freakdoctor/GameboyPi/GameboyPi2.png

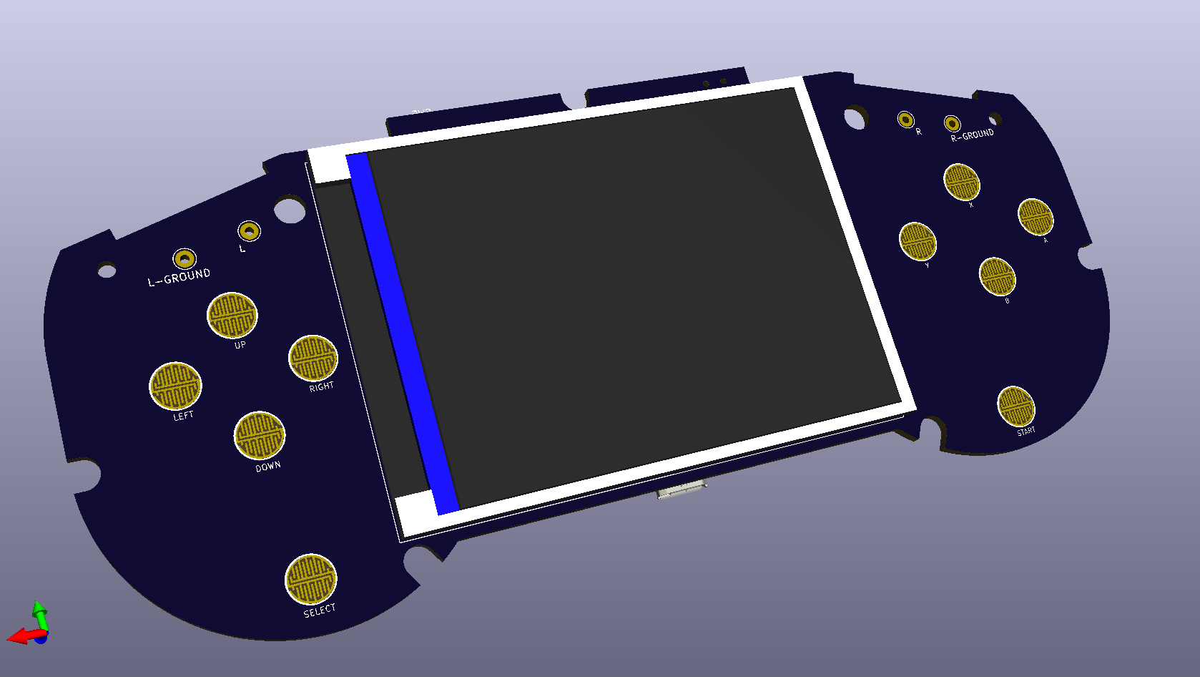
GameboyPi2.png
