freakdoctor/GameboyPi/GameboyPi.png

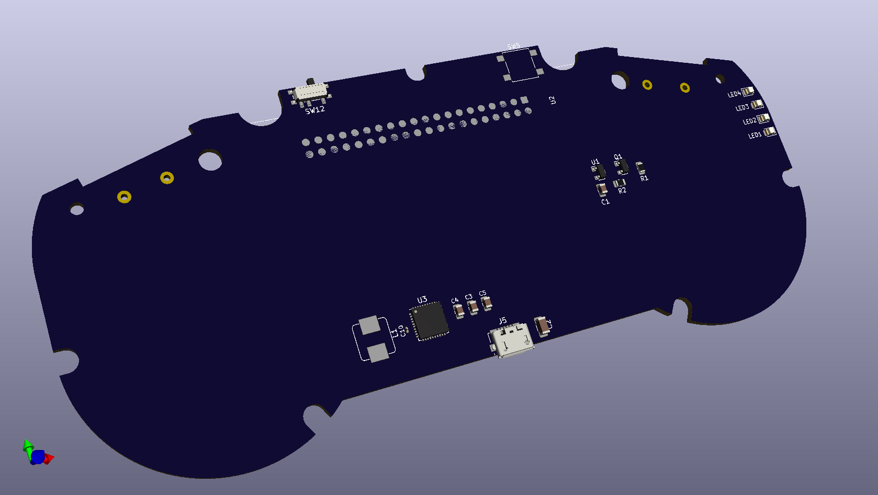
GameboyPi.png
