freakdoctor/GameboyPi/GameboyPi.kicad_pcb

## KiCad design GameboyPi.kicad_pcb (2022-04-14)

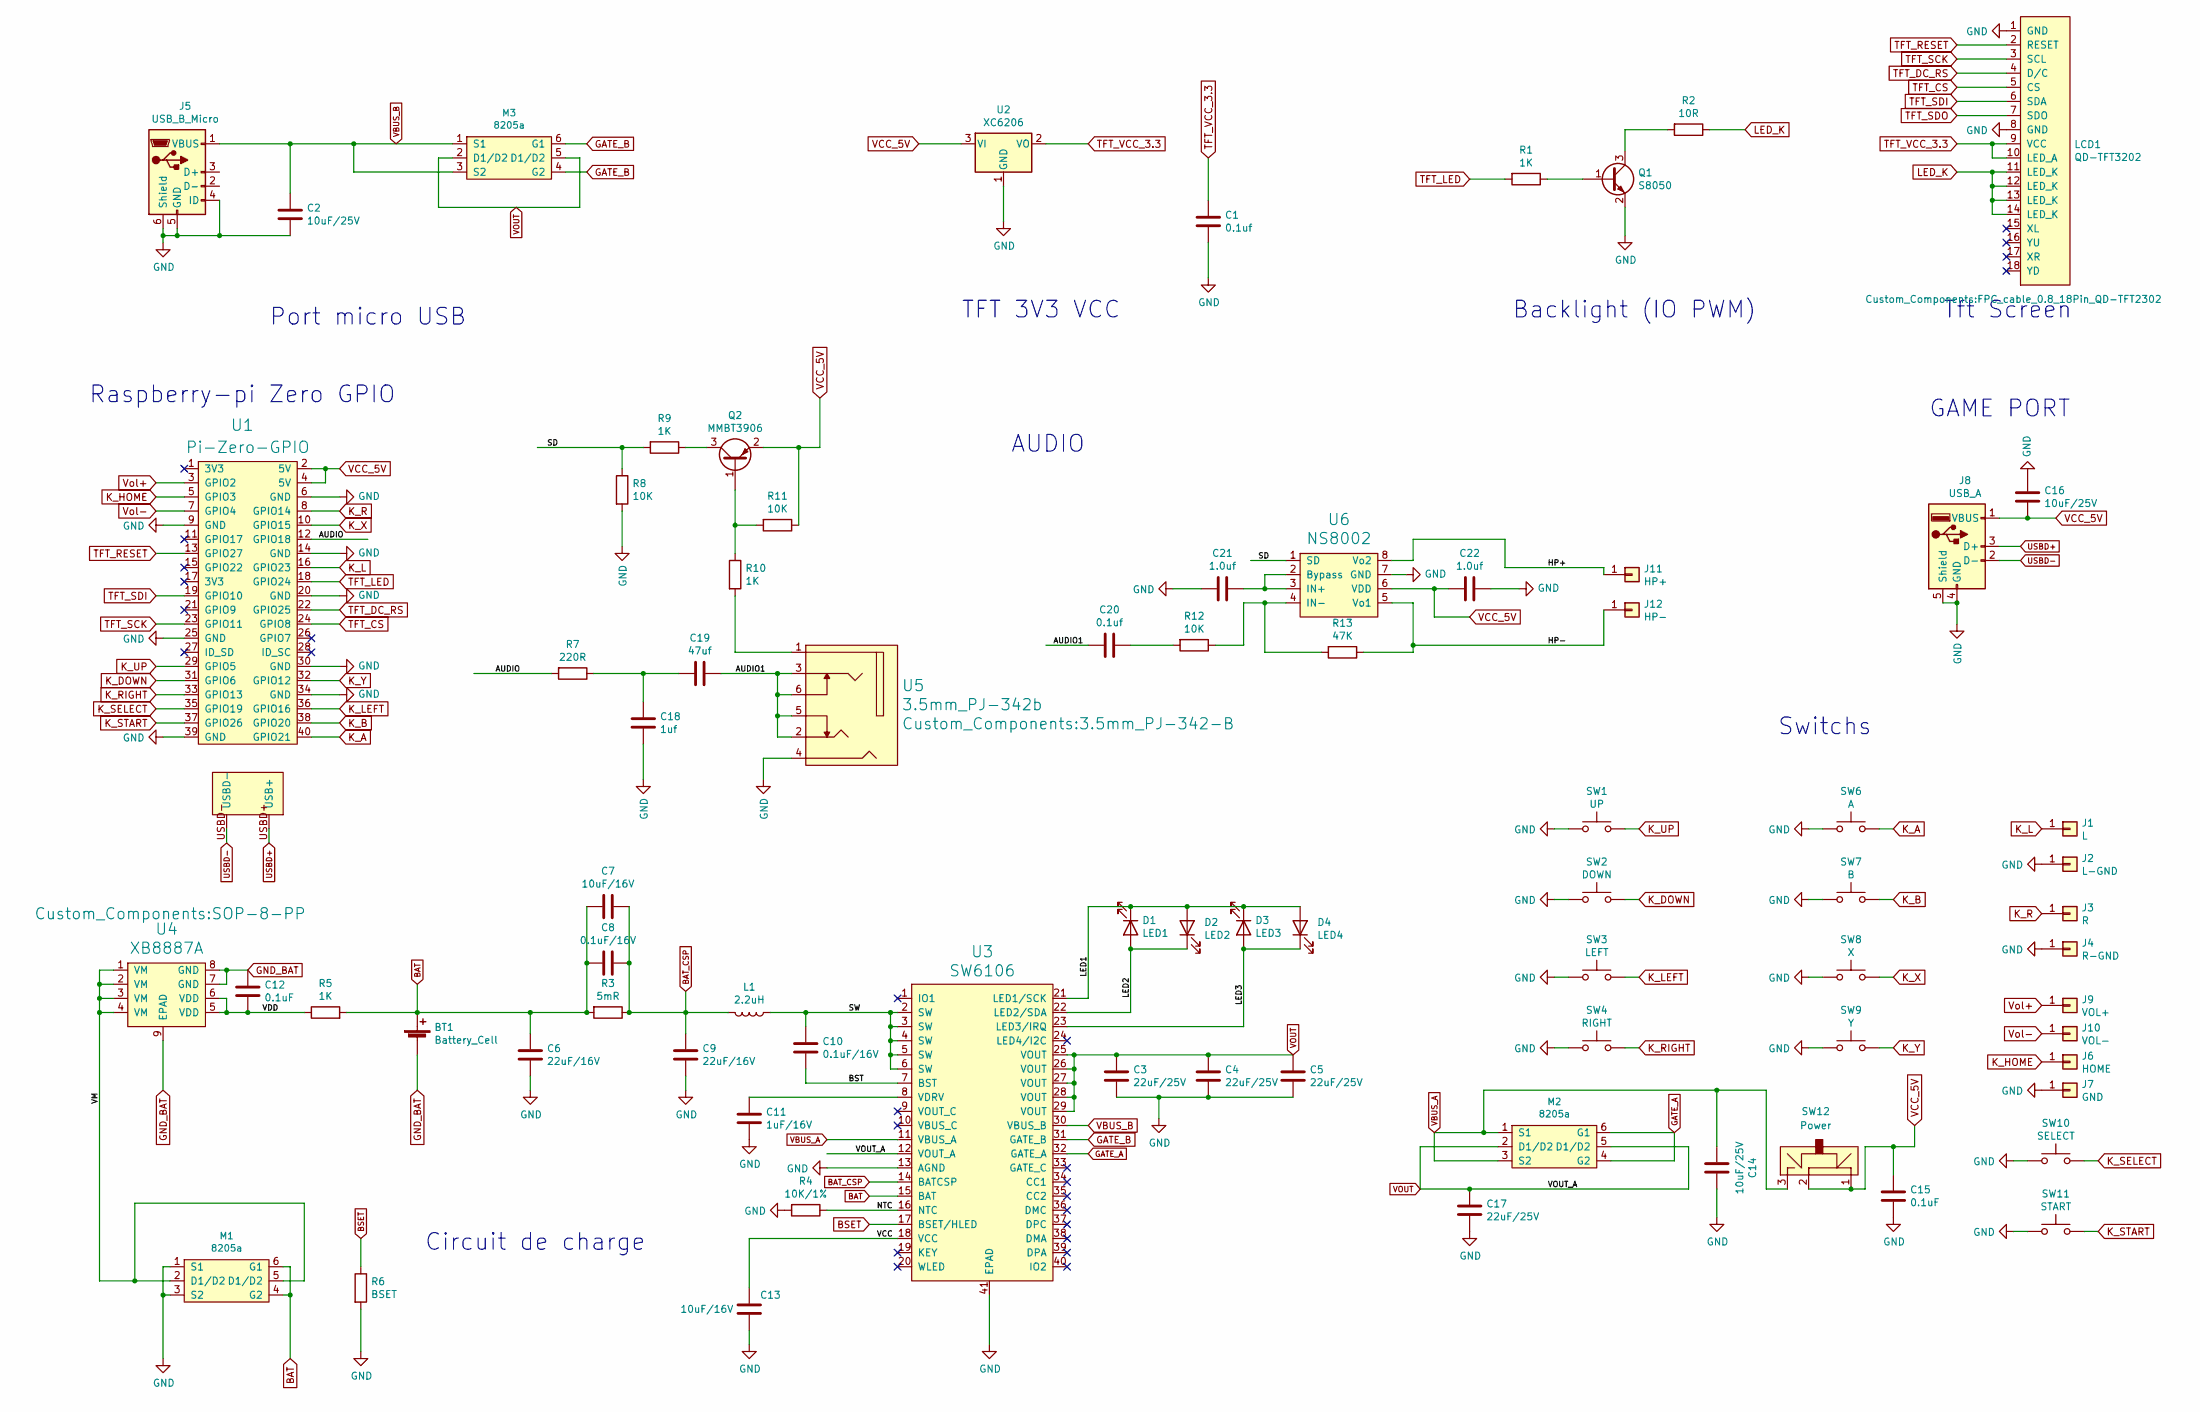
[picture p3: schematic GameboyPi.sch]

Parts:
BT1: Battery_Cell; Li-Po_3.7
C1: 0.1uf; C_0805_2012Metric; LCSC C286511
C2, C16: 10uF/25V; C_1206_3216Metric; LCSC C90538
C3, C4, C5, C17: 22uF/25V; C_0805_2012Metric; LCSC C90153
C6, C9: 22uF/16V; C_0805_2012Metric; LCSC C116973
C7, C13: 10uF/16V; C_0603_1608Metric; LCSC C70225
C8, C10: 0.1uF/16V; C_0603_1608Metric; LCSC C307478
C11: 1uF/16V; C_0603_1608Metric; LCSC C307478
C12: 0.1uF; C_0603_1608Metric; LCSC C307478
C14: 10uF/25V; C_1206_3216Metric; LCSC C70225
C15: 0.1uF; C_1206_3216Metric; LCSC C105213
C18: 1uf; C_0603_1608Metric
C19: 47uf; C_0603_1608Metric
C20: 0.1uf; C_0603_1608Metric
C21, C22: 1.0uf; C_0603_1608Metric
D1: LED1; LED_0805_2012Metric; LCSC C138557
D2: LED2; LED_0805_2012Metric; LCSC C138557
D3: LED3; LED_0805_2012Metric; LCSC C138557
D4: LED4; LED_0805_2012Metric; LCSC C138557
J1: L; Pin_D1.0mm_L10.0mm_LooseFit
J2: L-GND; Pin_D1.0mm_L10.0mm_LooseFit
J3: R; Pin_D1.0mm_L10.0mm_LooseFit
J4: R-GND; Pin_D1.0mm_L10.0mm_LooseFit
J5: USB_B_Micro; USB_Micro-B_Molex_47346-0001; LCSC C132560
J6: HOME; Edge_connection
J7: GND; Edge_connection
J8: USB_A; USB_A_Molex_67643_Horizontal; LCSC C2765194
J9: VOL+; Edge_connection
J10: VOL-; Edge_connection
J11: HP+; Edge_connection
J12: HP-; Edge_connection
L1: 2.2uH; L_Abracon_ASPI-0630LR
LCD1: QD-TFT3202; FPC_cable_0.8_18Pin_QD-TFT2302
M1, M2, M3: 8205a; SOT-23-6; LCSC C2762931
Q1: S8050; SOT-23; LCSC C2146
Q2: MMBT3906; SOT-23
R1: 1K; R_0805_2012Metric; LCSC C269744
R2: 10R; R_0805_2012Metric; LCSC C17477
R3: 5mR; R_1206_3216Metric; LCSC C601096
R4: 10K/1%; R_0603_1608Metric; LCSC C116677
R5: 1K; R_0603_1608Metric; LCSC C269704
R6: BSET; R_0805_2012Metric
R7: 220R; R_0603_1608Metric
R8, R11, R12: 10K; R_0603_1608Metric
R9, R10: 1K; R_0603_1608Metric
R13: 47K; R_0603_1608Metric
SW1: UP; Kbpad
SW2: DOWN; Kbpad
SW3: LEFT; Kbpad
SW4: RIGHT; Kbpad
SW6: A; Kbpad
SW7: B; Kbpad
SW8: X; Kbpad
SW9: Y; Kbpad
SW10: SELECT; Kbpad
SW11: START; Kbpad
SW12: Power; SW_SPDT_PCM12
U1: Pi-Zero-GPIO; Pi_Zero_SMD
U2: XC6206; SOT-23; LCSC C5446
U3: SW6106; QFN-40-1EP_6x6mm_P0.5mm_EP4.6x4.6mm_ThermalVias; LCSC C406803
U4: XB8887A; SOP-8-PP
U5: 3.5mm_PJ-342b; 3.5mm_PJ-342-B
U6: NS8002; SOP-8-PP

Connections:
/AUDIO: R7.2, U1.12 (GPIO18)
/AUDIO1: C19.1, C20.2, U5.2, U5.3, U5.5, U5.6
/BST: C10.1, U3.7 (BST)
/HP+: J11.1, U6.8 (Vo2); also elsewhere on the board
/HP-: J12.1, R13.1, U6.5 (Vo1); also elsewhere on the board
/LED1: D1.1 (K), D2.2 (A), D3.1 (K), D4.2 (A), U3.21 (LED1/SCK)
/LED2: D1.2 (A), D2.1 (K), U3.22 (LED2/SDA)
/LED3: D3.2 (A), D4.1 (K), U3.23 (LED3/IRQ)
/NTC: R4.1, U3.16 (NTC)
/SD: R8.1, R9.2, U6.1 (SD)
/SW: C10.2, L1.1, U3.2 (SW), U3.3 (SW), U3.4 (SW), U3.5 (SW), U3.6 (SW)
/VCC: C13.2, U3.18 (VCC)
/VDD: C12.2, R5.1, U4.5 (VDD), U4.6 (VDD)
/VM: M1.2 (D1/D2), M1.5 (D1/D2), U4.1 (VM), U4.2 (VM), U4.3 (VM), U4.4 (VM)
BAT: BT1.1 (+), C6.1, C7.2, C8.2, M1.4 (G2), M1.6 (G1), R3.2, R5.2, U3.15 (BAT); also elsewhere on the board
BAT_CSP: C7.1, C8.1, C9.1, L1.2, R3.1, U3.14 (BATCSP)
BSET: R6.1, U3.17 (BSET/HLED)
GATE_A: M2.4 (G2), M2.6 (G1), U3.32 (GATE_A)
GATE_B: M3.4 (G2), M3.6 (G1), U3.31 (GATE_B)
GND: C1.2, C2.2, C3.2, C4.2, C5.2, C6.2, C9.2, C11.2, C13.1, C14.1, C15.2, C16.1, C17.2, C18.1, C21.2, C22.1, J2.1, J4.1, J5.4 (ID), J5.5 (GND), J5.6 (Shield), J7.1, J8.4 (GND), J8.5 (Shield), LCD1.1 (GND), LCD1.8 (GND), M1.1 (S1), M1.3 (S2), Q1.2 (E), R4.2, R6.2, R8.2, SW1.1, SW2.1, SW3.1, SW4.1, SW6.1, SW7.1, SW8.1, SW9.1, SW10.1, SW11.1, U1.6 (GND), U1.9 (GND), U1.14 (GND), U1.20 (GND), U1.25 (GND), U1.30 (GND), U1.34 (GND), U1.39 (GND), U2.1 (GND), U3.13 (AGND), U3.41 (EPAD), U5.4, U6.7 (GND)
GND_BAT: BT1.2 (-), C12.1, U4.7 (GND), U4.8 (GND), U4.9 (EPAD); also elsewhere on the board
K_A: SW6.2, U1.40 (GPIO21)
K_B: SW7.2, U1.38 (GPIO20)
K_DOWN: SW2.2, U1.31 (GPIO6)
K_HOME: J6.1, U1.5 (GPIO3)
K_L: J1.1, U1.16 (GPIO23)
K_LEFT: SW3.2, U1.36 (GPIO16)
K_R: J3.1, U1.8 (GPIO14)
K_RIGHT: SW4.2, U1.33 (GPIO13)
K_SELECT: SW10.2, U1.35 (GPIO19)
K_START: SW11.2, U1.37 (GPIO26)
K_UP: SW1.2, U1.29 (GPIO5)
K_X: SW8.2, U1.10 (GPIO15)
K_Y: SW9.2, U1.32 (GPIO12)
LED_K: LCD1.11 (LED_K), LCD1.12 (LED_K), LCD1.13 (LED_K), LCD1.14 (LED_K), R2.1
unnamed: C11.1, U3.8 (VDRV)
unnamed: C18.2, C19.2, R7.1
unnamed: C20.1, R12.2
unnamed: C21.1, U6.2 (Bypass), U6.3 (IN+)
unnamed: Q1.1 (B), R1.1
unnamed: Q1.3 (C), R2.2
unnamed: Q2.1 (B), R10.1, R11.2
unnamed: Q2.3 (C), R9.1
unnamed: R10.2, U5.1
unnamed: R12.1, R13.2, U6.4 (IN-)
TFT_CS: LCD1.5 (CS), U1.24 (GPIO8)
TFT_DC_RS: LCD1.4 (D/C), U1.22 (GPIO25)
TFT_LED: R1.2, U1.18 (GPIO24)
TFT_RESET: LCD1.2 (RESET), U1.13 (GPIO27)
TFT_SCK: LCD1.3 (SCL), U1.23 (GPIO11)
TFT_SDI: LCD1.6 (SDA), U1.19 (GPIO10)
TFT_SDO: LCD1.7 (SDO)
TFT_VCC_3.3: C1.1, LCD1.9 (VCC), LCD1.10 (LED_A), U2.2 (VO)
USBD+: J8.3 (D+), U1.USBD+ (USB+)
USBD-: J8.2 (D-), U1.USBD-
VBUS_A: C14.2, M2.1 (S1), M2.3 (S2), SW12.3, U3.11 (VBUS_A)
VBUS_B: C2.1, J5.1 (VBUS), M3.1 (S1), M3.3 (S2), U3.30 (VBUS_B)
VCC_5V: C15.1, C16.2, C22.2, J8.1 (VBUS), Q2.2 (E), R11.1, SW12.1, SW12.2, U1.2 (5V), U1.4 (5V), U2.3 (VI), U6.6 (VDD)
VOUT: C3.1, C4.1, C5.1, C17.1, M2.2 (D1/D2), M2.5 (D1/D2), M3.2 (D1/D2), M3.5 (D1/D2), U3.12 (VOUT_A), U3.25 (VOUT), U3.26 (VOUT), U3.27 (VOUT), U3.28 (VOUT), U3.29 (VOUT)
Vol+: J9.1, U1.3 (GPIO2); also elsewhere on the board
Vol-: J10.1, U1.7 (GPIO4); also elsewhere on the board

Notes on the sheet:
TFT 3V3 VCC
Raspberry-pi Zero GPIO
Port micro USB
Circuit de charge
GAME PORT
Switchs
Backlight (IO PWM)
Tft Screen
AUDIO

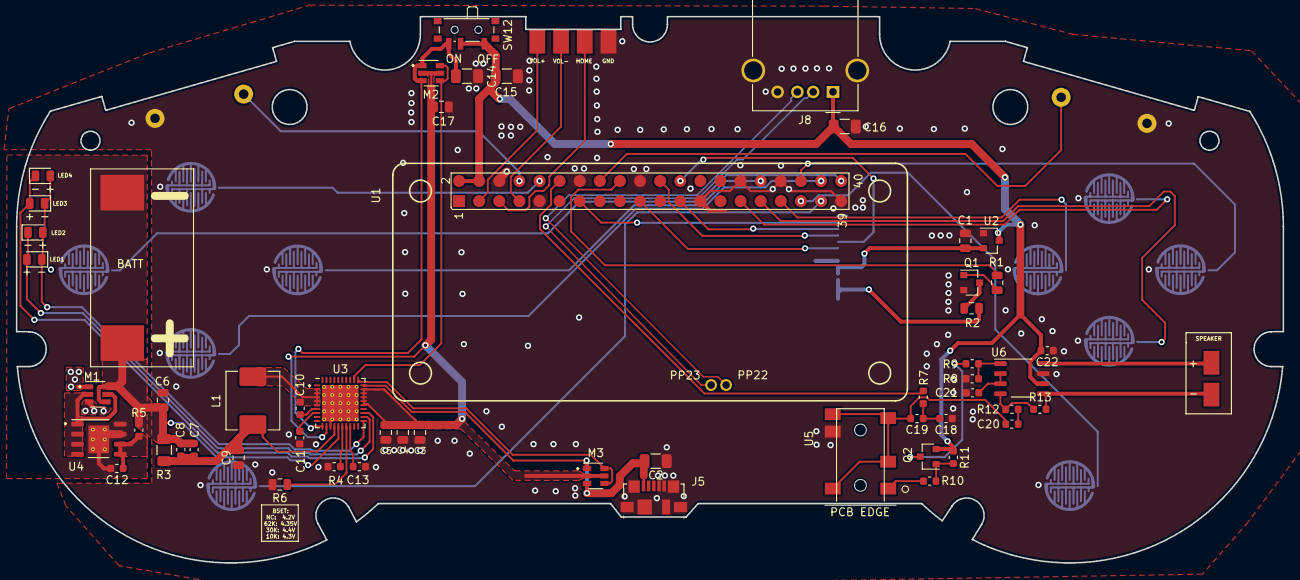
[picture p4: board GameboyPi.kicad_pcb from above]

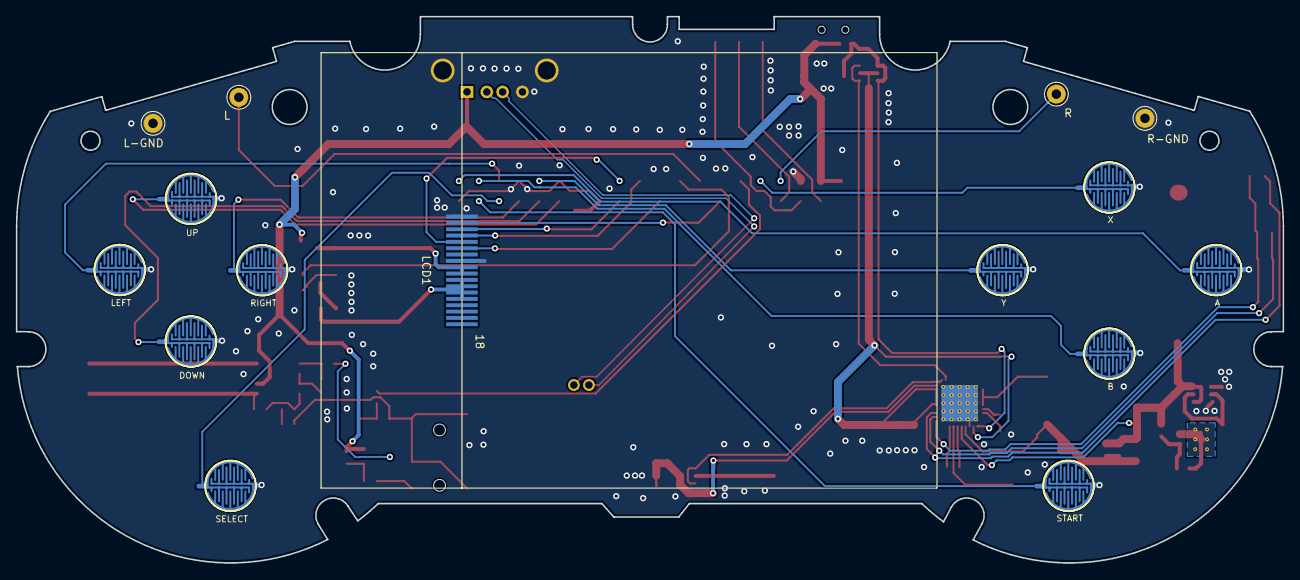
[picture p5: board GameboyPi.kicad_pcb from below]

Board: 2 copper layers, 160.0 x 69.0 mm, 76 parts (15 on the bottom side), 60 nets.

Other parts of the board:
+: HP+; Edge_connection
-: HP-; Edge_connection
BATT: Battery_Cell; Li-Po_3.7
VOL+: VOL+; Edge_connection
VOL-: VOL-; Edge_connection

Their connections:
/HP+: +.1; also elsewhere on the board
/HP-: -.1; also elsewhere on the board
BAT: BATT.1; also elsewhere on the board
GND_BAT: BATT.2; also elsewhere on the board
Vol+: VOL+.1; also elsewhere on the board
Vol-: VOL-.1; also elsewhere on the board
