freakdoctor/GameboyPi/(commit log)

2022-04-14 SuperPiTendo
    SuperPiTendo
    [Chargeur Li-Po.kicad_pcb, Chargeur Li-Po.sch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]
2022-04-23 maj kicad
